ews-motionlab/esp32_lolin_clone/README.md

# esp32_lolin_clone
Design files for a PCB replicating the functionality and shape of the ESP32 lolin32 board.
