ews-motionlab/esp32_lolin_clone/esp32_lolin_clone.brd

## EAGLE design esp32_lolin_clone.brd (2023-02-20)

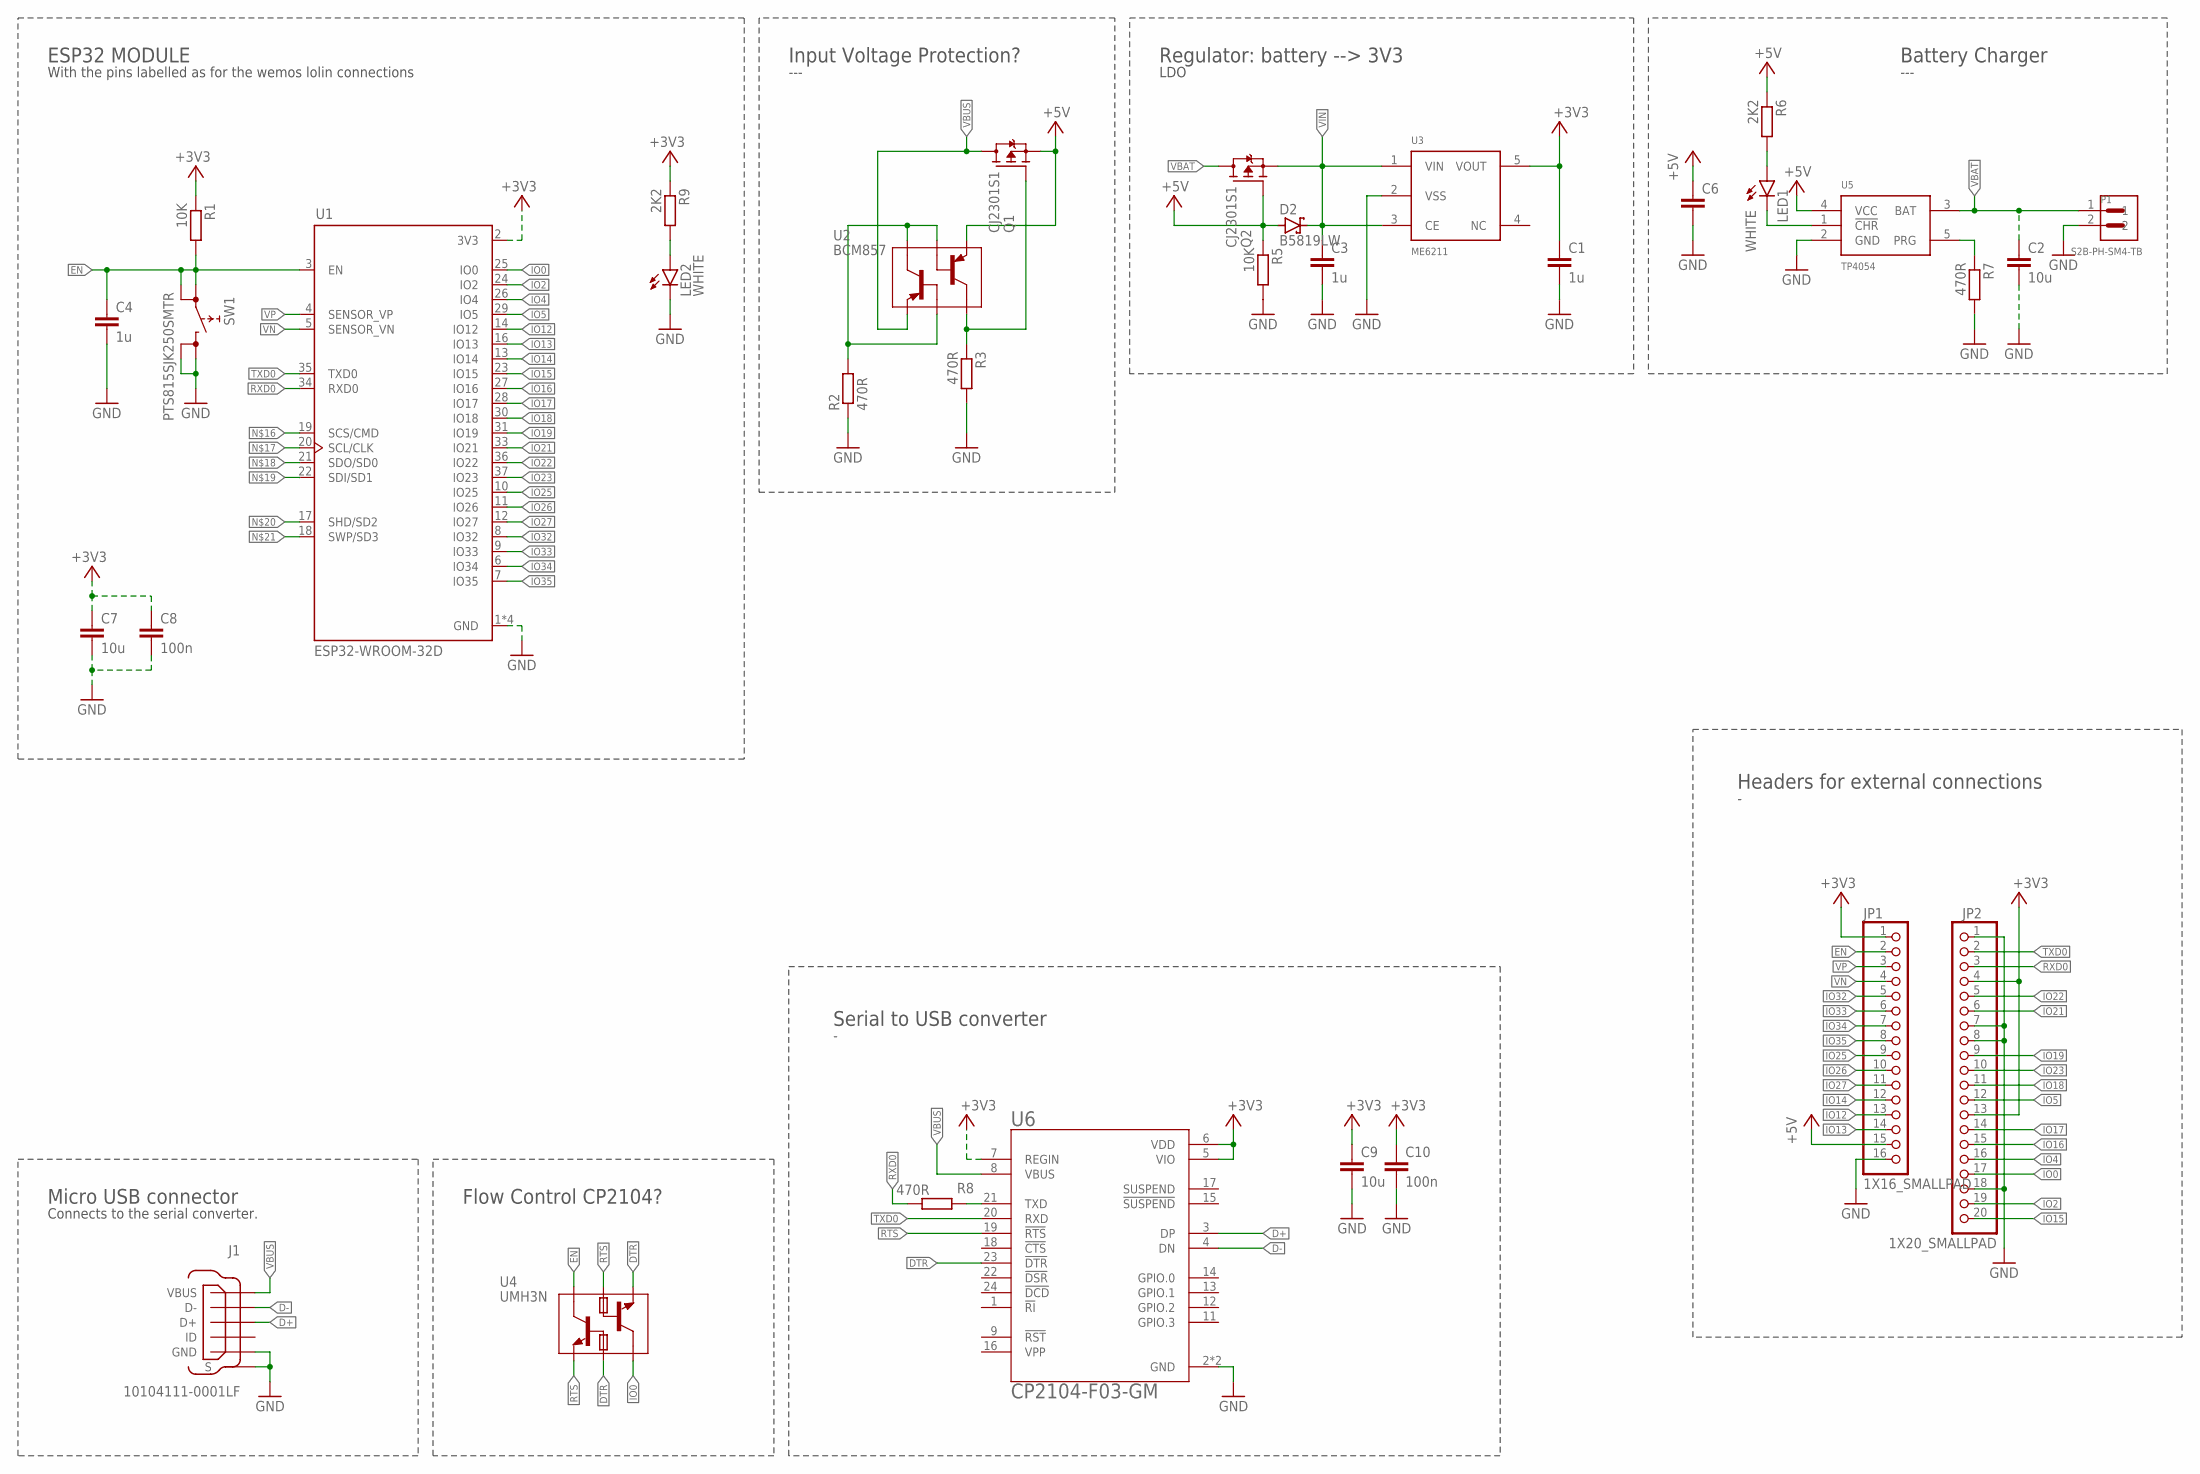
[picture p1: schematic esp32_lolin_clone.sch]

Parts:
C1, C3, C4: 1u; C0603K
C2, C7, C9: 10u; C0603K
C6: C-EUC0603K; C0603K
C8, C10: 100n; C0603K
D2: B5819LW; SOD123
J1: 10104111-0001LF; FRAMATOME_10104111-0001LF
JP1: 1X16_SMALLPAD; 1X16
JP2: 1X20_SMALLPAD; 1X20
LED1, LED2: WHITE; CHIP-LED0603
P1: S2B-PH-SM4-TB; JST_S2B-PH-SM4-TB
Q1, Q2: CJ2301S1; SOT23
R1, R5: 10K; R0603
R2, R3, R7, R8: 470R; R0603
R6, R9: 2K2; R0603
SW1: PTS815SJK250SMTR
U1: ESP32-WROOM-32D; MODULE_ESP32-WROOM-32D
U2: BCM857; SOT363_INFINEON
U3: ME6211; SOT23-5
U4: UMH3N; SOT363_INFINEON
U5: TP4054; SOT23-5
U6: CP2104-F03-GM; QFN50P400X400X80-25N

Connections:
+3V3: C1.1, C7.1, C8.1, C9.1, C10.1, JP1.1, JP2.4, JP2.13, R1.1, R9.1, U1.2 (3V3), U3.5 (VOUT), U6.5 (VIO), U6.6 (VDD), U6.7 (REGIN)
+5V: C6.1, D2.2 (A), JP1.15, Q1.2 (S), Q2.1 (G), R5.1, R6.1, U2.4 (E2), U5.4 (VCC)
D+: J1.3 (D+), U6.3 (DP)
D-: J1.2 (D-), U6.4 (DN)
DTR: U4.2 (B1), U4.4 (E2), U6.23 (!DTR)
EN: C4.1, JP1.2, R1.2, SW1.1 (0), SW1.2 (0), U1.3 (EN), U4.6 (C1)
GND: C1.2, C2.2, C3.2, C4.2, C6.2, C7.2, C8.2, C9.2, C10.2, J1.5 (GND), J1.6 (S), J1.7 (S), J1.8 (S), J1.9 (S), JP1.16, JP2.1, JP2.7, JP2.8, JP2.18, LED2.C, P1.2, R2.1, R3.2, R5.2, R7.2, SW1.3 (1), SW1.4 (1), U1.1 (GND), U1.15 (GND), U1.38 (GND), U1.39 (GND), U3.2 (VSS), U5.2 (GND), U6.2 (GND), U6.25 (GND)
IO0: JP2.17, U1.25 (IO0), U4.3 (C2)
IO2: JP2.19, U1.24 (IO2)
IO4: JP2.16, U1.26 (IO4)
IO5: JP2.12, U1.29 (IO5)
IO12: JP1.13, U1.14 (IO12)
IO13: JP1.14, U1.16 (IO13)
IO14: JP1.12, U1.13 (IO14)
IO15: JP2.20, U1.23 (IO15)
IO16: JP2.15, U1.27 (IO16)
IO17: JP2.14, U1.28 (IO17)
IO18: JP2.11, U1.30 (IO18)
IO19: JP2.9, U1.31 (IO19)
IO21: JP2.6, U1.33 (IO21)
IO22: JP2.5, U1.36 (IO22)
IO23: JP2.10, U1.37 (IO23)
IO25: JP1.9, U1.10 (IO25)
IO26: JP1.10, U1.11 (IO26)
IO27: JP1.11, U1.12 (IO27)
IO32: JP1.5, U1.8 (IO32)
IO33: JP1.6, U1.9 (IO33)
IO34: JP1.7, U1.6 (IO34)
IO35: JP1.8, U1.7 (IO35)
unnamed: R8.1, U6.21 (TXD)
unnamed: LED2.A, R9.2
unnamed: LED1.C, U5.1 (!CHR)
unnamed: LED1.A, R6.2
unnamed: R2.2, U2.2 (B1), U2.5 (B2), U2.6 (C1)
unnamed: Q1.1 (G), R3.1, U2.3 (C2)
unnamed: R7.1, U5.5 (PRG)
RTS: U4.1 (E1), U4.5 (B2), U6.19 (!RTS)
RXD0: JP2.3, R8.2, U1.34 (RXD0)
TXD0: JP2.2, U1.35 (TXD0), U6.20 (RXD)
VBAT: C2.1, P1.1, Q2.3 (D), U5.3 (BAT)
VBUS: J1.1 (VBUS), Q1.3 (D), U2.1 (E1), U6.8 (VBUS)
VIN: C3.1, D2.1 (C), Q2.2 (S), U3.1 (VIN), U3.3 (CE)
VN: JP1.4, U1.5 (SENSOR_VN)
VP: JP1.3, U1.4 (SENSOR_VP)

Notes on the sheet:
ESP32 MODULE
With the pins labelled as for the wemos lolin connections
Regulator: battery --> 3V3
LDO
Battery Charger
---
Serial to USB converter
Micro USB connector
Connects to the serial converter.
Input Voltage Protection?
Headers for external connections
Flow Control CP2104?

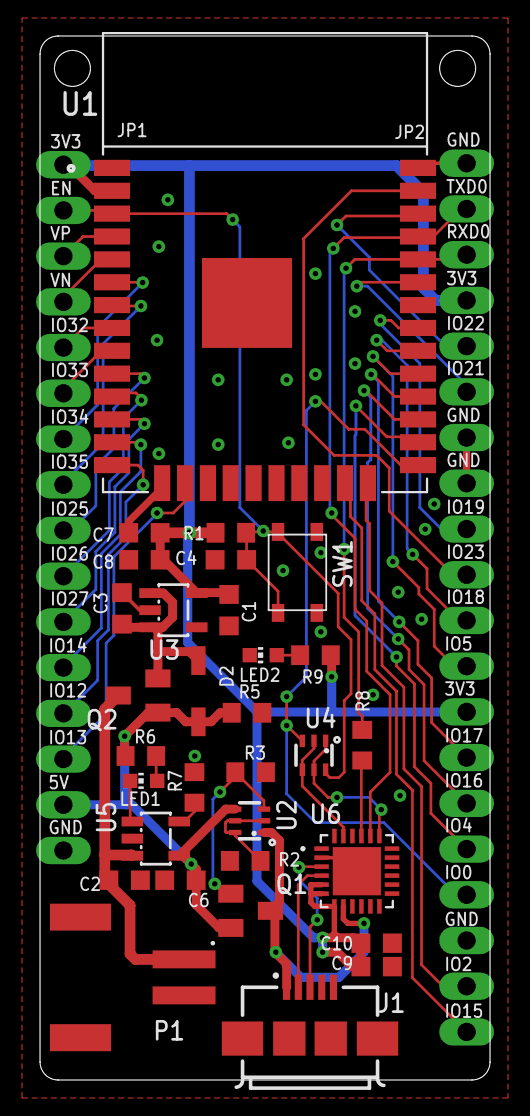
[picture p2: board esp32_lolin_clone.brd from above]

Board: 2 copper layers, 25.0 x 58.0 mm, 34 parts (1 on the bottom side), 44 nets.

Other parts of the board:
U$1: RE_LOGO_10MM
