ews-motionlab/esp32_lolin_clone/(commit log)

2020-01-18 Add Schematic and Board design files.
    [esp32_lolin_clone.brd, esp32_lolin_clone.sch]
2020-01-20 Routing and changing position of some components.
    [esp32_lolin_clone.brd, esp32_lolin_clone.sch]
2021-02-08 - Finish first routing attempt. - Add notes to schematic.
    [esp32_lolin_clone.brd, esp32_lolin_clone.sch]
2021-02-08 - set traces to the correct size.
    [esp32_lolin_clone.brd, esp32_lolin_clone.sch]
2021-02-08 - check part designators are readable.
    [esp32_lolin_clone.brd]
2021-02-08 - Add BOM as exported from EAGLE.
    [esp32_lolin_clone.csv]
2021-02-09 - Finish BOM, modify BOM related issues in schematic.
    [esp32_lolin_clone.brd, esp32_lolin_clone.sch, esp32_lolin_clone.xlsx]
2021-02-09 - Fix critical error 5V connection missing.
    [esp32_lolin_clone.brd, esp32_lolin_clone.sch]
2021-02-12 - As sent to manufacture on 13.12.2021
    [esp32_lolin_clone.brd, esp32_lolin_clone.xlsx]
2021-04-23 - Add a test protocol for the PCB.
2021-04-23 - Change device reference BCM857, so it really matches the footprint at the board.
    [esp32_lolin_clone.brd, esp32_lolin_clone.sch]
2021-04-26 - FIX CRITICAL ERROR: Battery connector pins were swapped.
    [esp32_lolin_clone.brd, esp32_lolin_clone.sch]
2023-02-20 - Add labels on silk for all pins on top and bottom. - remove lines between pins to improve visibility of pin names.
    [esp32_lolin_clone.brd, esp32_lolin_clone.sch]
